feecat/PicoIndustrial/KiCadLibraries/HF46F_024-HS1T.stp

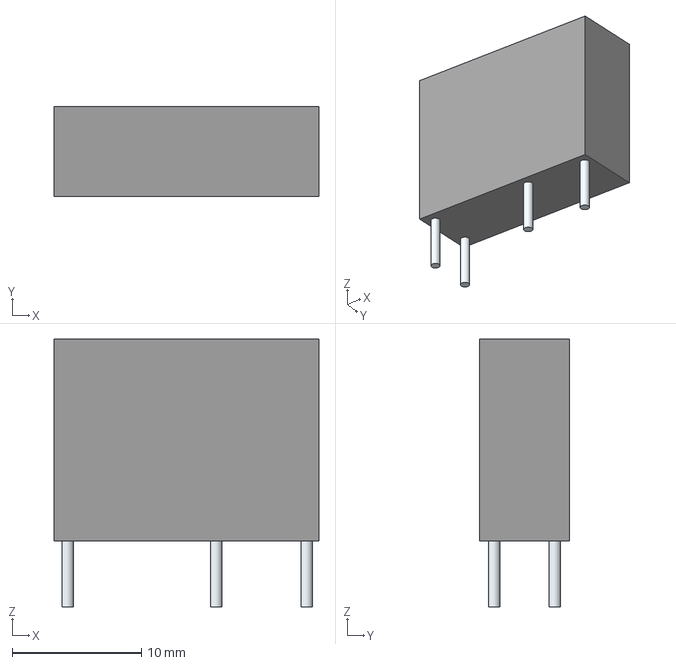
[picture p5: CAD file, 2021-03-18]
KiCadLibraries/HF46F_024-HS1T.stp
20.5 x 7.00 x 20.7 mm
Leads x 4
