feecat/PicoIndustrial/KiCadLibraries/WJ15EDGVC-3.81-12P.stp

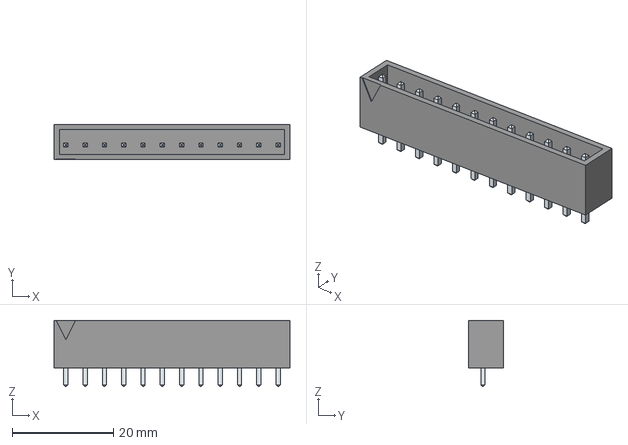
[picture p6: CAD file, 2021-03-18]
KiCadLibraries/WJ15EDGVC-3.81-12P.stp
46.6 x 7.00 x 13.1 mm
LeadsArray
