feecat/PicoIndustrial/KiCadLibraries/WJ15EDGVC-3.81-10P.stp

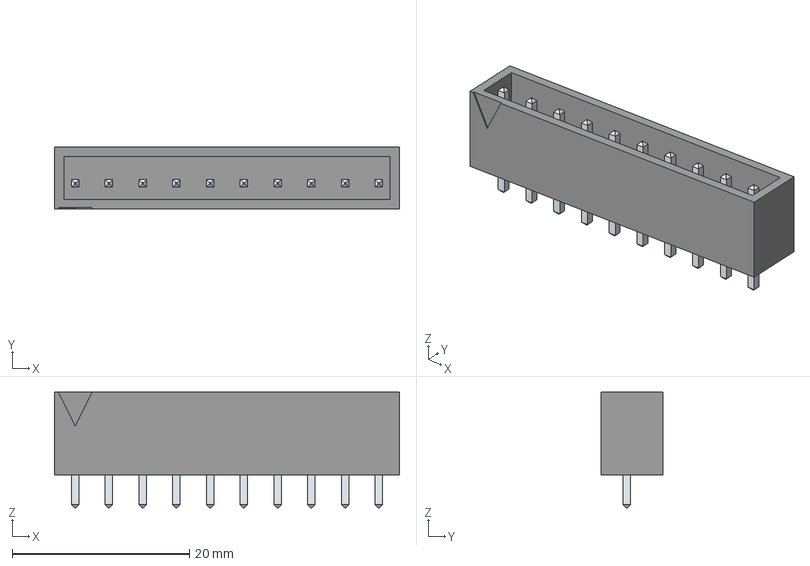
[picture p7: CAD file, 2021-03-18]
KiCadLibraries/WJ15EDGVC-3.81-10P.stp
39.0 x 7.00 x 13.1 mm
LeadsArray
