feecat/PicoIndustrial/KiCadLibraries/LM258D.stp

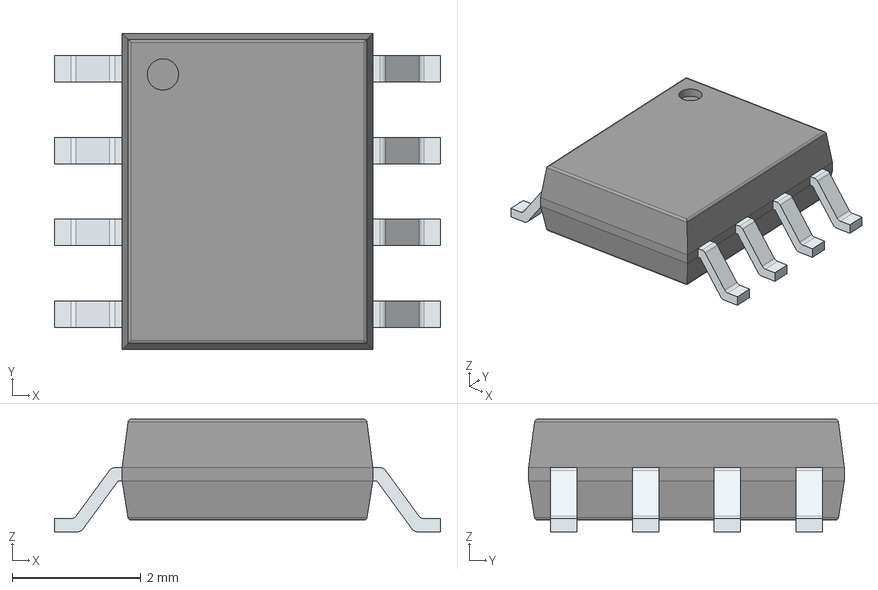
[picture p8: CAD file, 2021-03-18]
KiCadLibraries/LM258D.stp
6.00 x 4.91 x 1.75 mm
PinsArrayLR
