feecat/PicoIndustrial/PicoIndustrial.kicad_pcb

## KiCad design PicoIndustrial.kicad_pcb (2021-03-18)

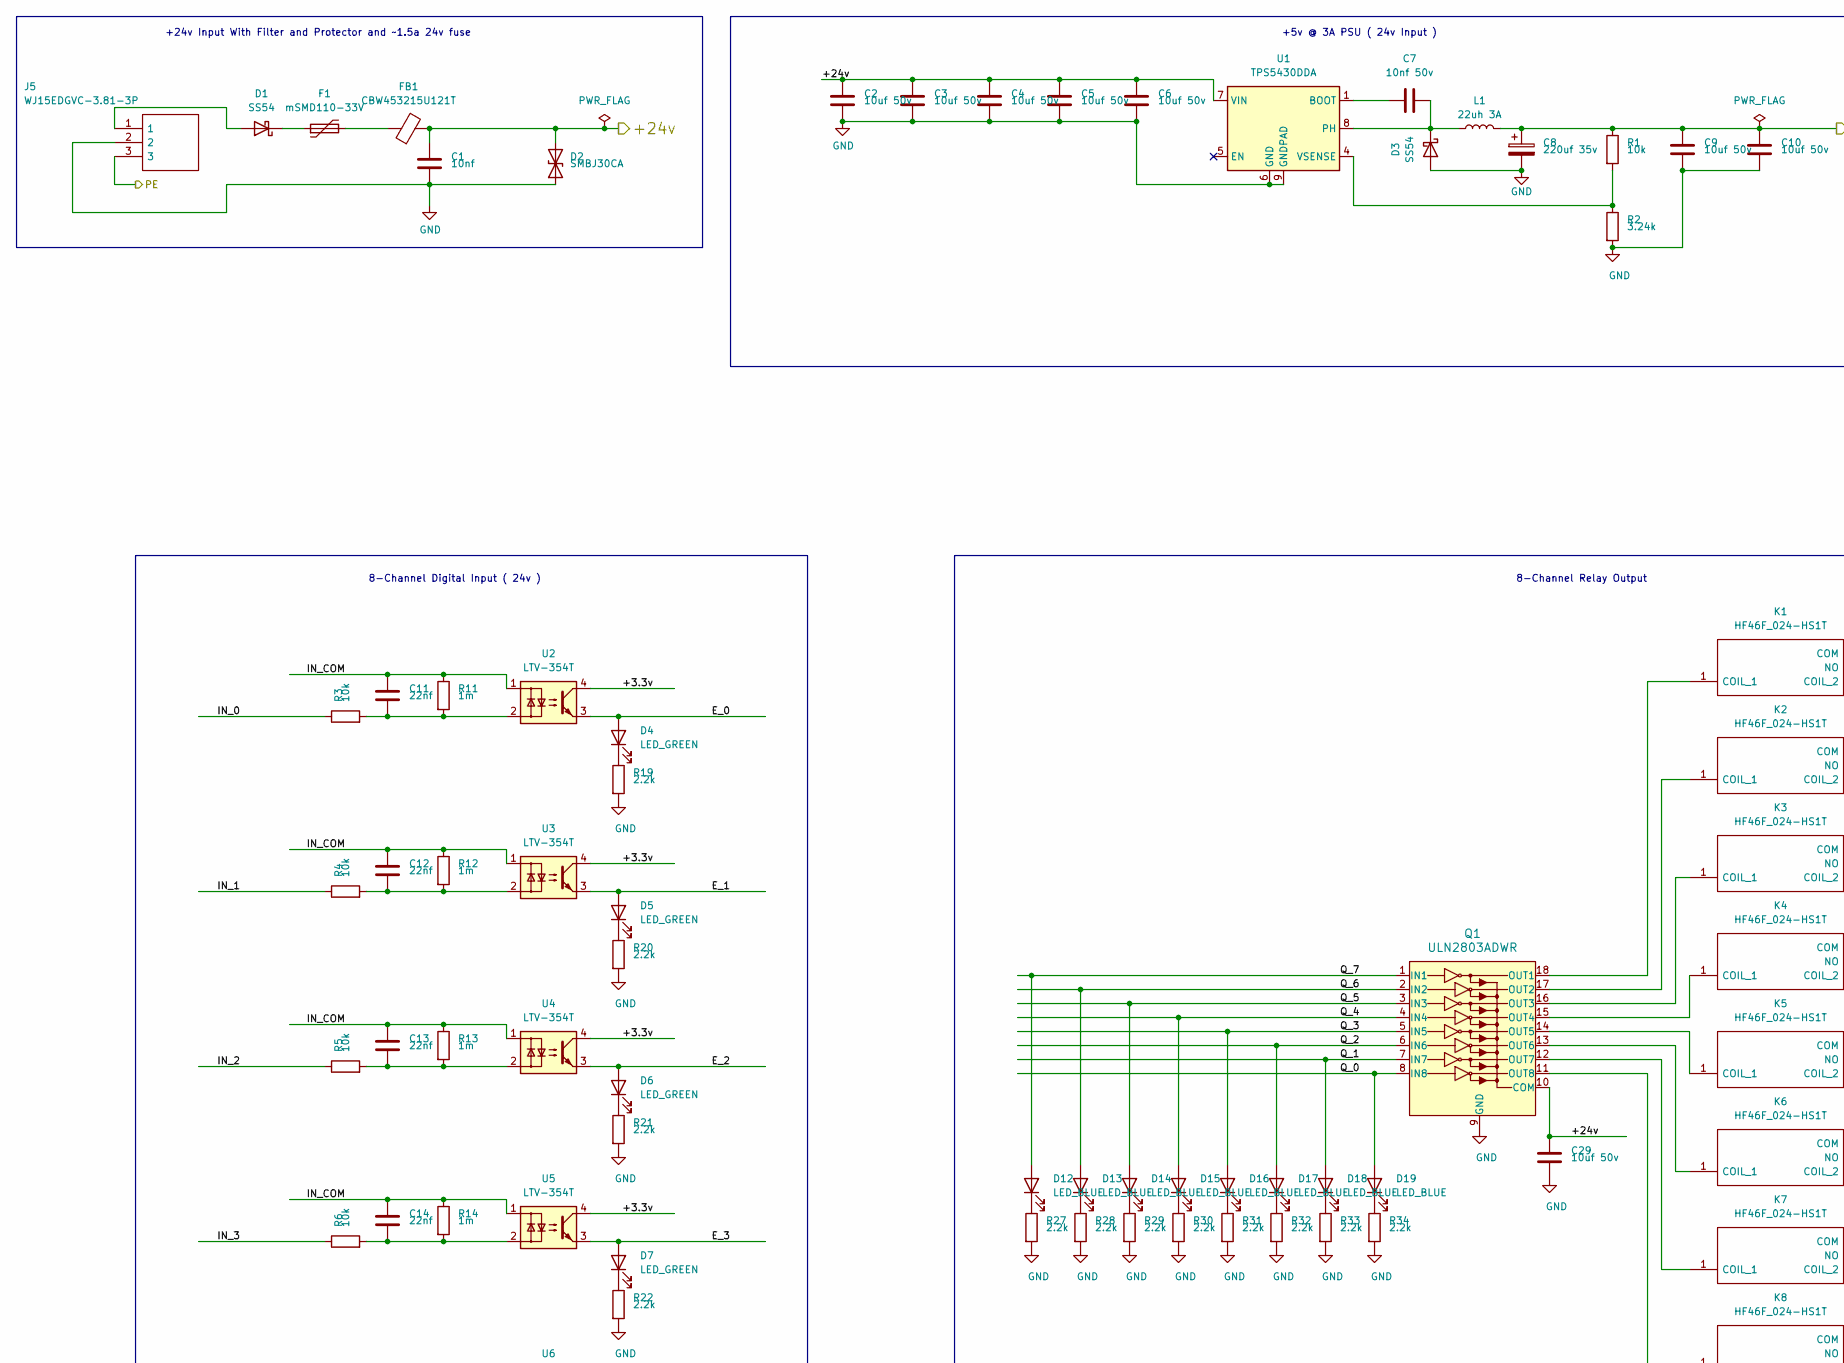
[picture p9: schematic PicoIndustrial.kicad_sch, part in row 1, column 1]

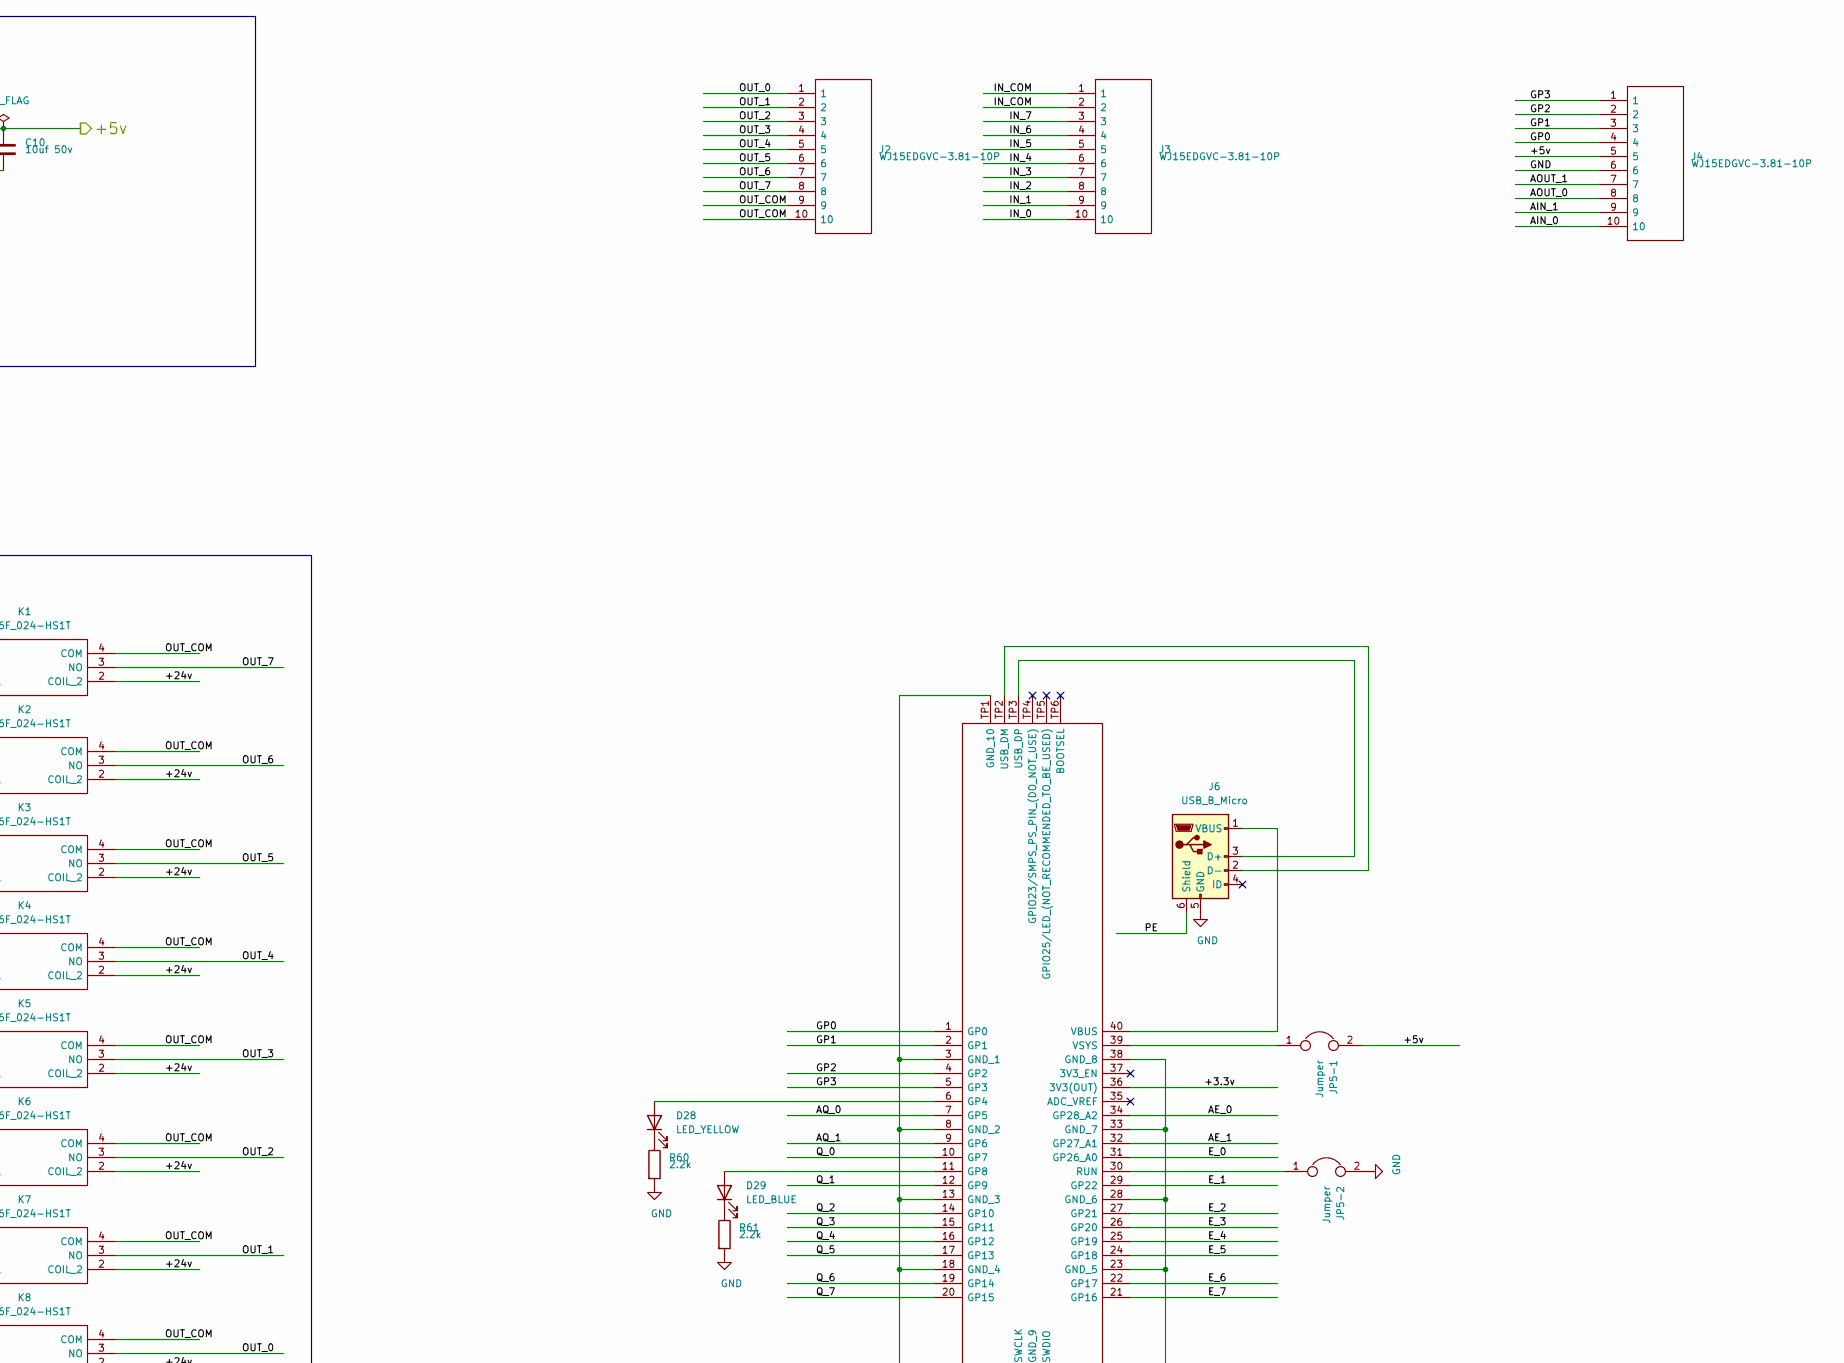
[picture p10: schematic PicoIndustrial.kicad_sch, part in row 1, column 2]

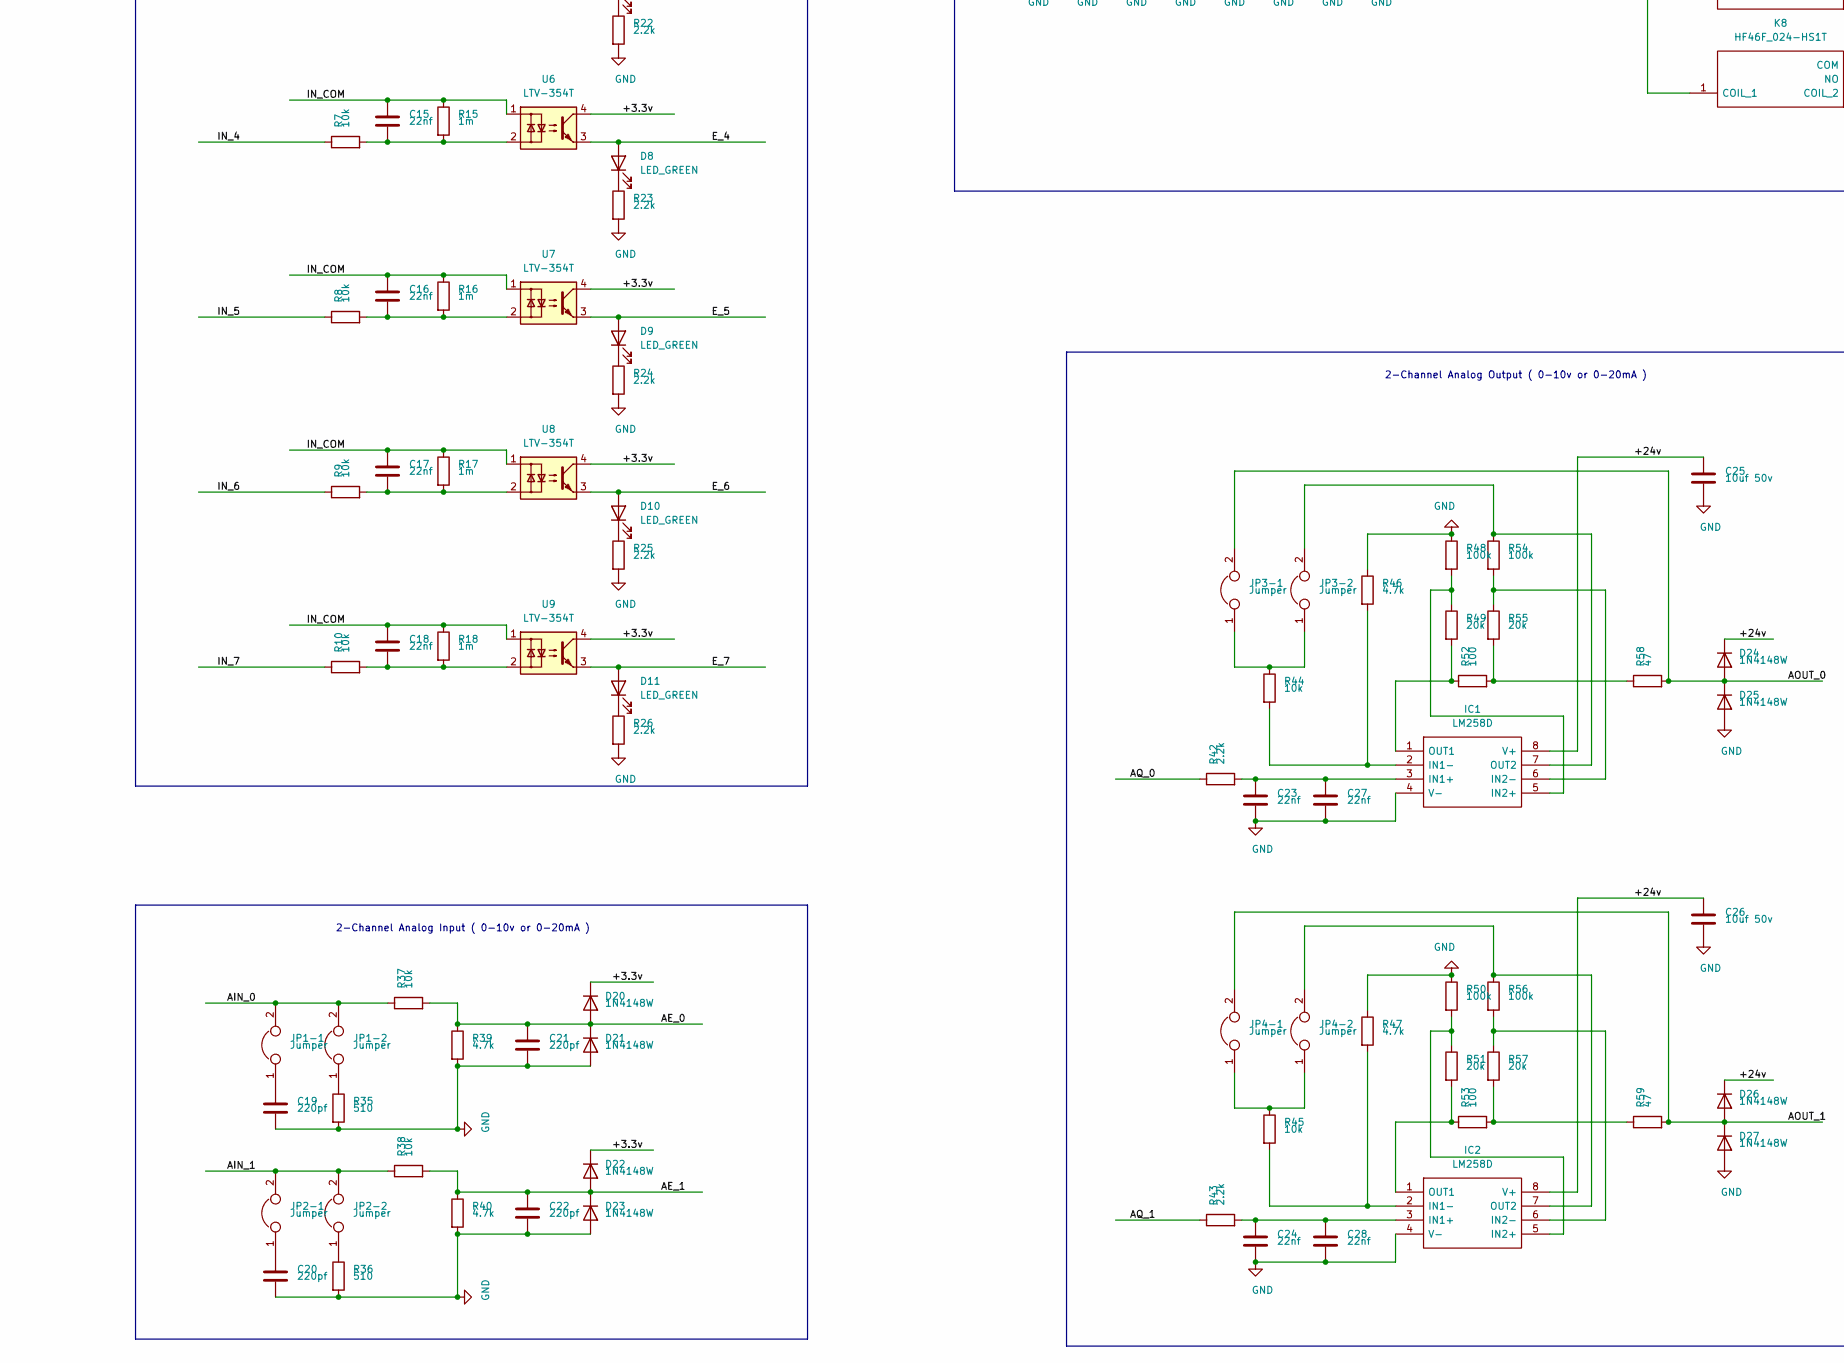
[picture p11: schematic PicoIndustrial.kicad_sch, part in row 2, column 1]

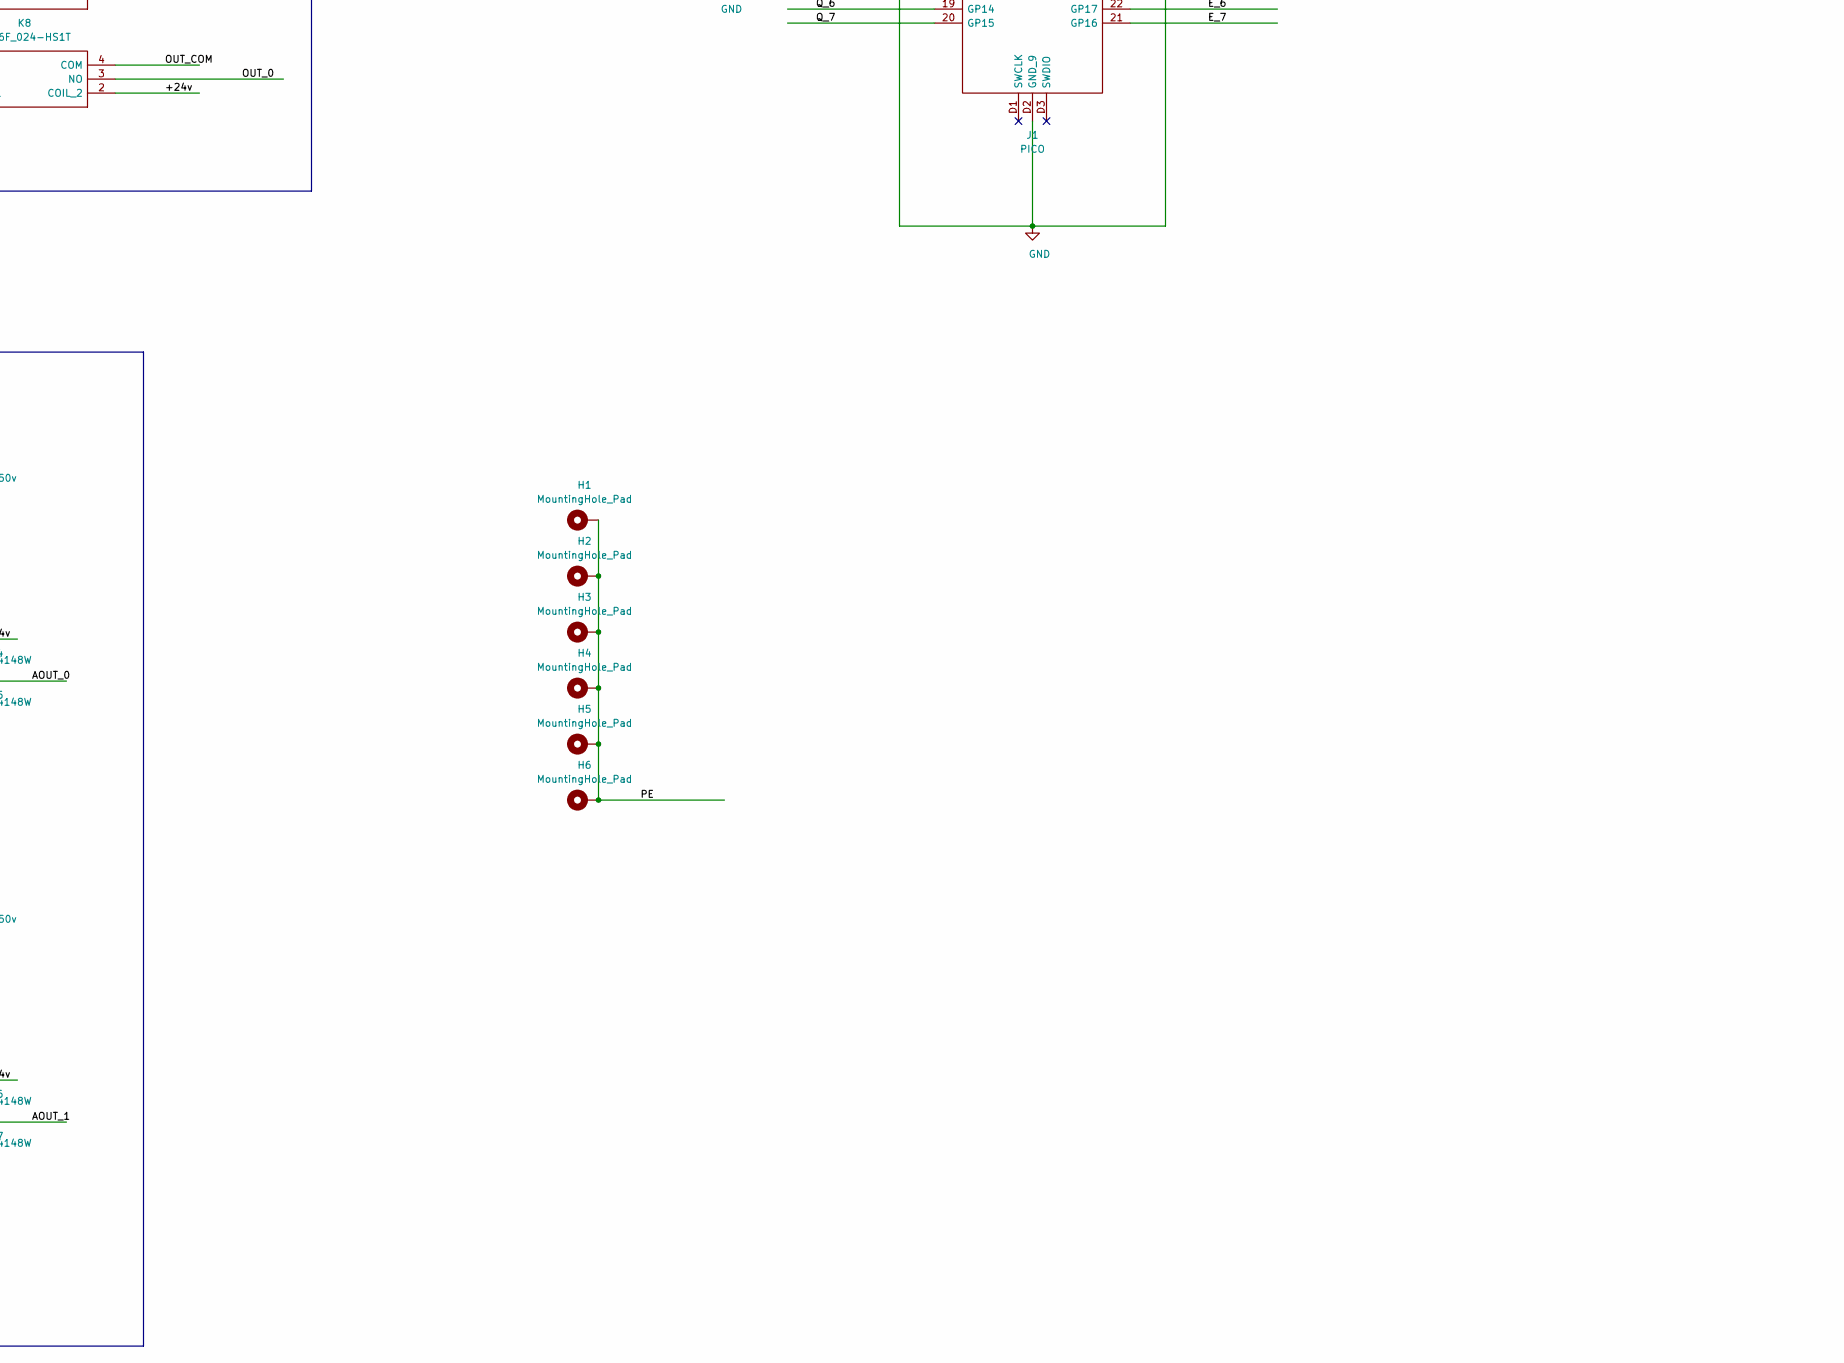
[picture p12: schematic PicoIndustrial.kicad_sch, part in row 2, column 2]

Parts:
C1: 10nf; C_1812_4532Metric; MPN 1812B103K202NT
C2, C3, C4, C5, C6, C9, C10, C25, C26, C29: 10uf 50v; C_1206_3216Metric; MPN CL31A106KBHNNNE
C7: 10nf 50v; C_0603_1608Metric; MPN CL10B103KB8NNNC
C8: 220uf 35v; CP_Elec_8x10; MPN VEH221M1VTR-0810
C11, C12, C13, C14, C15, C16, C17, C18, C23, C24, C27, C28: 22nf; C_0603_1608Metric; MPN CL10B223KB8NNNC
C19, C20, C21, C22: 220pf; C_0603_1608Metric; MPN CL10B221KB8NNNC
D1, D3: SS54; D_SMA; MPN SS54
D2: SMBJ30CA; D_SMB; MPN SMBJ30CA
D4, D5, D6, D7, D8, D9, D10, D11: LED_GREEN; LED_0603_1608Metric; MPN 19-217/GHC-YR1S2/3T
D12, D13, D14, D15, D16, D17, D18, D19, D29: LED_BLUE; LED_0603_1608Metric; MPN 19-217/BHC-ZL1M2RY/3T
D20, D21, D22, D23, D24, D25, D26, D27: 1N4148W; D_SOD-123; MPN 1N4148W
D28: LED_YELLOW; LED_0603_1608Metric; MPN 19-213/Y2C-CQ2R2L/3T(CY)
F1: mSMD110-33V; Fuse_1812_4532Metric; MPN mSMD110-33V
FB1: CBW453215U121T; L_1812_4532Metric; MPN CBW453215U121T
H1, H2, H3, H4, H5, H6: MountingHole_Pad; MountingHole_3.2mm_M3_Pad_Via
IC1, IC2: LM258D; SOIC127P600X175-8N; MPN LM258DR
J1: PICO; PICO_HOLE; MPN Pico
J2, J3, J4: WJ15EDGVC-3.81-10P; SHDR10W85P0X381_1X10_3898X700X935P; MPN WJ15EDGVC-3.81-10P
J5: WJ15EDGVC-3.81-3P; SHDR12W85P0X381_1X3_4660X700X935P; MPN WJ15EDGVM-3.81-3P
J6: USB_B_Micro; USB_Micro-B_Wuerth_614105150721_Vertical; MPN MICRO 180°JB
JP1-1, JP1-2, JP2-1, JP2-2, JP3-1, JP3-2, JP4-1, JP4-2, JP5-1, JP5-2: Jumper; TestPoint_2Pads_Pitch2.54mm_Drill0.8mm
K1, K2, K3, K4, K5, K6, K7, K8: HF46F_024-HS1T; HF46F024HS1T; MPN HF46F/24-HS1
L1: 22uh 3A; L_12x12mm_H6mm; MPN SLH1207S220MTT
Q1: ULN2803ADWR; SOIC-18W_7.5x11.6mm_P1.27mm
R1, R3, R4, R5, R6, R7, R8, R9, R10, R37, R38, R44, R45: 10k; R_0603_1608Metric; MPN 0603WAF1002T5E
R2: 3.24k; R_0603_1608Metric; MPN 0603WAF3241T5E
R11, R12, R13, R14, R15, R16, R17, R18: 1m; R_0603_1608Metric; MPN 0603WAF1004T5E
R19, R20, R21, R22, R23, R24, R25, R26, R27, R28, R29, R30, R31, R32, R33, R34, R42, R43, R60, R61: 2.2k; R_0603_1608Metric; MPN 0603WAF2201T5E
R35, R36: 510; R_1206_3216Metric; MPN 1206W4F5100T5E
R39, R40, R46, R47: 4.7k; R_0603_1608Metric; MPN 0603WAF4701T5E
R48, R50, R54, R56: 100k; R_0603_1608Metric; MPN 0603WAF1003T5E
R49, R51, R55, R57: 20k; R_0603_1608Metric; MPN 0603WAF2002T5E
R52, R53: 100; R_0603_1608Metric; MPN 0603WAF1000T5E
R58, R59: 47; R_0603_1608Metric; MPN 0603WAF470JT5E
U1: TPS5430DDA; TI_SO-PowerPAD-8_ThermalVias; MPN TPS5430DDAR
U2, U3, U4, U5, U6, U7, U8, U9: LTV-354T; SO-4_4.4x3.6mm_P2.54mm; MPN LTV-354T

Connections:
/+3.3v: D20.1 (K), D22.1 (K), J1.36 (3V3(OUT)), U2.4, U3.4, U4.4, U5.4, U6.4, U7.4, U8.4, U9.4
/+5v: C8.1, C9.1, C10.1, J4.5, JP5-1.2, L1.2, R1.1
/+24v: C1.1, C2.1, C3.1, C4.1, C5.1, C6.1, C25.1, C26.1, C29.1, D2.2 (A2), D24.1 (K), D26.1 (K), FB1.2, IC1.8 (V+), IC2.8 (V+), K1.2 (COIL_2), K2.2 (COIL_2), K3.2 (COIL_2), K4.2 (COIL_2), K5.2 (COIL_2), K6.2 (COIL_2), K7.2 (COIL_2), K8.2 (COIL_2), Q1.10 (COM), U1.7 (VIN)
/AE_0: C21.2, D20.2 (A), D21.1 (K), J1.34 (GP28_A2), R37.2, R39.1
/AE_1: C22.2, D22.2 (A), D23.1 (K), J1.32 (GP27_A1), R38.2, R40.1
/AIN_0: J4.10, JP1-1.2, JP1-2.2, R37.1
/AIN_1: J4.9, JP2-1.2, JP2-2.2, R38.1
/AOUT_0: D24.2 (A), D25.1 (K), J4.8, JP3-1.2, R58.2
/AOUT_1: D26.2 (A), D27.1 (K), J4.7, JP4-1.2, R59.2
/AQ_0: J1.7 (GP5), R42.1
/AQ_1: J1.9 (GP6), R43.1
/E_0: D4.2 (A), J1.31 (GP26_A0), U2.3
/E_1: D5.2 (A), J1.29 (GP22), U3.3
/E_2: D6.2 (A), J1.27 (GP21), U4.3
/E_3: D7.2 (A), J1.26 (GP20), U5.3
/E_4: D8.2 (A), J1.25 (GP19), U6.3
/E_5: D9.2 (A), J1.24 (GP18), U7.3
/E_6: D10.2 (A), J1.22 (GP17), U8.3
/E_7: D11.2 (A), J1.21 (GP16), U9.3
/GP0: J1.1 (GP0), J4.4
/GP1: J1.2 (GP1), J4.3
/GP2: J1.4 (GP2), J4.2
/GP3: J1.5 (GP3), J4.1
/IN_0: J3.10, R3.1
/IN_1: J3.9, R4.1
/IN_2: J3.8, R5.1
/IN_3: J3.7, R6.1
/IN_4: J3.6, R7.1
/IN_5: J3.5, R8.1
/IN_6: J3.4, R9.1
/IN_7: J3.3, R10.1
/IN_COM: C11.2, C12.2, C13.2, C14.2, C15.2, C16.2, C17.2, C18.2, J3.1, J3.2, R11.1, R12.1, R13.1, R14.1, R15.1, R16.1, R17.1, R18.1, U2.1, U3.1, U4.1, U5.1, U6.1, U7.1, U8.1, U9.1
/OUT_0: J2.1, K8.3 (NO)
/OUT_1: J2.2, K7.3 (NO)
/OUT_2: J2.3, K6.3 (NO)
/OUT_3: J2.4, K5.3 (NO)
/OUT_4: J2.5, K4.3 (NO)
/OUT_5: J2.6, K3.3 (NO)
/OUT_6: J2.7, K2.3 (NO)
/OUT_7: J2.8, K1.3 (NO)
/OUT_COM: J2.9, J2.10, K1.4 (COM), K2.4 (COM), K3.4 (COM), K4.4 (COM), K5.4 (COM), K6.4 (COM), K7.4 (COM), K8.4 (COM)
/PE: H1.1, H2.1, H3.1, H4.1, H5.1, H6.1, J5.3, J6.6 (Shield)
/Q_0: D19.2 (A), J1.10 (GP7), Q1.8 (IN8)
/Q_1: D18.2 (A), J1.12 (GP9), Q1.7 (IN7)
/Q_2: D17.2 (A), J1.14 (GP10), Q1.6 (IN6)
/Q_3: D16.2 (A), J1.15 (GP11), Q1.5 (IN5)
/Q_4: D15.2 (A), J1.16 (GP12), Q1.4 (IN4)
/Q_5: D14.2 (A), J1.17 (GP13), Q1.3 (IN3)
/Q_6: D13.2 (A), J1.19 (GP14), Q1.2 (IN2)
/Q_7: D12.2 (A), J1.20 (GP15), Q1.1 (IN1)
GND: C1.2, C2.2, C3.2, C4.2, C5.2, C6.2, C8.2, C9.2, C10.2, C19.1, C20.1, C21.1, C22.1, C23.1, C24.1, C25.2, C26.2, C27.1, C28.1, C29.2, D2.1 (A1), D3.2 (A), D21.2 (A), D23.2 (A), D25.2 (A), D27.2 (A), IC1.4 (V-), IC2.4 (V-), J1.3 (GND_1), J1.8 (GND_2), J1.13 (GND_3), J1.18 (GND_4), J1.23 (GND_5), J1.28 (GND_6), J1.33 (GND_7), J1.38 (GND_8), J1.D2 (GND_9), J1.TP1 (GND_10), J4.6, J5.2, J6.5 (GND), JP5-2.2, Q1.9 (GND), R2.2, R19.2, R20.2, R21.2, R22.2, R23.2, R24.2, R25.2, R26.2, R27.2, R28.2, R29.2, R30.2, R31.2, R32.2, R33.2, R34.2, R35.2, R36.2, R39.2, R40.2, R46.1, R47.1, R48.1, R50.1, R60.2, R61.2, U1.6 (GND), U1.9 (GNDPAD)
unnamed: C7.1, U1.1 (BOOT)
unnamed: C7.2, D3.1 (K), L1.1, U1.8 (PH)
unnamed: C11.1, R3.2, R11.2, U2.2
unnamed: C12.1, R4.2, R12.2, U3.2
unnamed: C13.1, R5.2, R13.2, U4.2
unnamed: C14.1, R6.2, R14.2, U5.2
unnamed: C15.1, R7.2, R15.2, U6.2
unnamed: C16.1, R8.2, R16.2, U7.2
unnamed: C17.1, R9.2, R17.2, U8.2
unnamed: C18.1, R10.2, R18.2, U9.2
unnamed: C19.2, JP1-1.1
unnamed: C20.2, JP2-1.1
unnamed: C23.2, C27.2, IC1.3 (IN1+), R42.2
unnamed: C24.2, C28.2, IC2.3 (IN1+), R43.2
unnamed: D1.1 (K), F1.1
unnamed: D1.2 (A), J5.1
unnamed: D4.1 (K), R19.1
unnamed: D5.1 (K), R20.1
unnamed: D6.1 (K), R21.1
unnamed: D7.1 (K), R22.1
unnamed: D8.1 (K), R23.1
unnamed: D9.1 (K), R24.1
unnamed: D10.1 (K), R25.1
unnamed: D11.1 (K), R26.1
unnamed: D12.1 (K), R27.1
unnamed: D13.1 (K), R28.1
unnamed: D14.1 (K), R29.1
unnamed: D15.1 (K), R30.1
unnamed: D16.1 (K), R31.1
unnamed: D17.1 (K), R32.1
unnamed: D18.1 (K), R33.1
unnamed: D19.1 (K), R34.1
unnamed: D28.1 (K), R60.1
unnamed: D28.2 (A), J1.6 (GP4)
unnamed: D29.1 (K), R61.1
unnamed: D29.2 (A), J1.11 (GP8)
unnamed: F1.2, FB1.1
unnamed: IC1.1 (OUT1), R49.2, R52.1
unnamed: IC1.2 (IN1-), R44.2, R46.2
unnamed: IC1.5 (IN2+), R48.2, R49.1
unnamed: IC1.6 (IN2-), R54.2, R55.1
unnamed: IC1.7 (OUT2), JP3-2.2, R54.1
unnamed: IC2.1 (OUT1), R51.2, R53.1
unnamed: IC2.2 (IN1-), R45.2, R47.2
unnamed: IC2.5 (IN2+), R50.2, R51.1
unnamed: IC2.6 (IN2-), R56.2, R57.1
unnamed: IC2.7 (OUT2), JP4-2.2, R56.1
unnamed: J1.30 (RUN), JP5-2.1
unnamed: J1.39 (VSYS), JP5-1.1
unnamed: J1.40 (VBUS), J6.1 (VBUS)
unnamed: J1.TP2 (USB_DM), J6.2 (D-)
unnamed: J1.TP3 (USB_DP), J6.3 (D+)
unnamed: JP1-2.1, R35.1
unnamed: JP2-2.1, R36.1
unnamed: JP3-1.1, JP3-2.1, R44.1
unnamed: JP4-1.1, JP4-2.1, R45.1
unnamed: K1.1 (COIL_1), Q1.18 (OUT1)
unnamed: K2.1 (COIL_1), Q1.17 (OUT2)
unnamed: K3.1 (COIL_1), Q1.16 (OUT3)
unnamed: K4.1 (COIL_1), Q1.15 (OUT4)
unnamed: K5.1 (COIL_1), Q1.14 (OUT5)
unnamed: K6.1 (COIL_1), Q1.13 (OUT6)
unnamed: K7.1 (COIL_1), Q1.12 (OUT7)
unnamed: K8.1 (COIL_1), Q1.11 (OUT8)
unnamed: R1.2, R2.1, U1.4 (VSENSE)
unnamed: R52.2, R55.2, R58.1
unnamed: R53.2, R57.2, R59.1

Notes on the sheet:
+24v Input With Filter and Protector and ~~1.5a 24v fuse
8-Channel Digital Input ( 24v )
2-Channel Analog Input ( 0-10v or 0-20mA )
+5v @ 3A PSU ( 24v Input )
8-Channel Relay Output
2-Channel Analog Output ( 0-10v or 0-20mA )

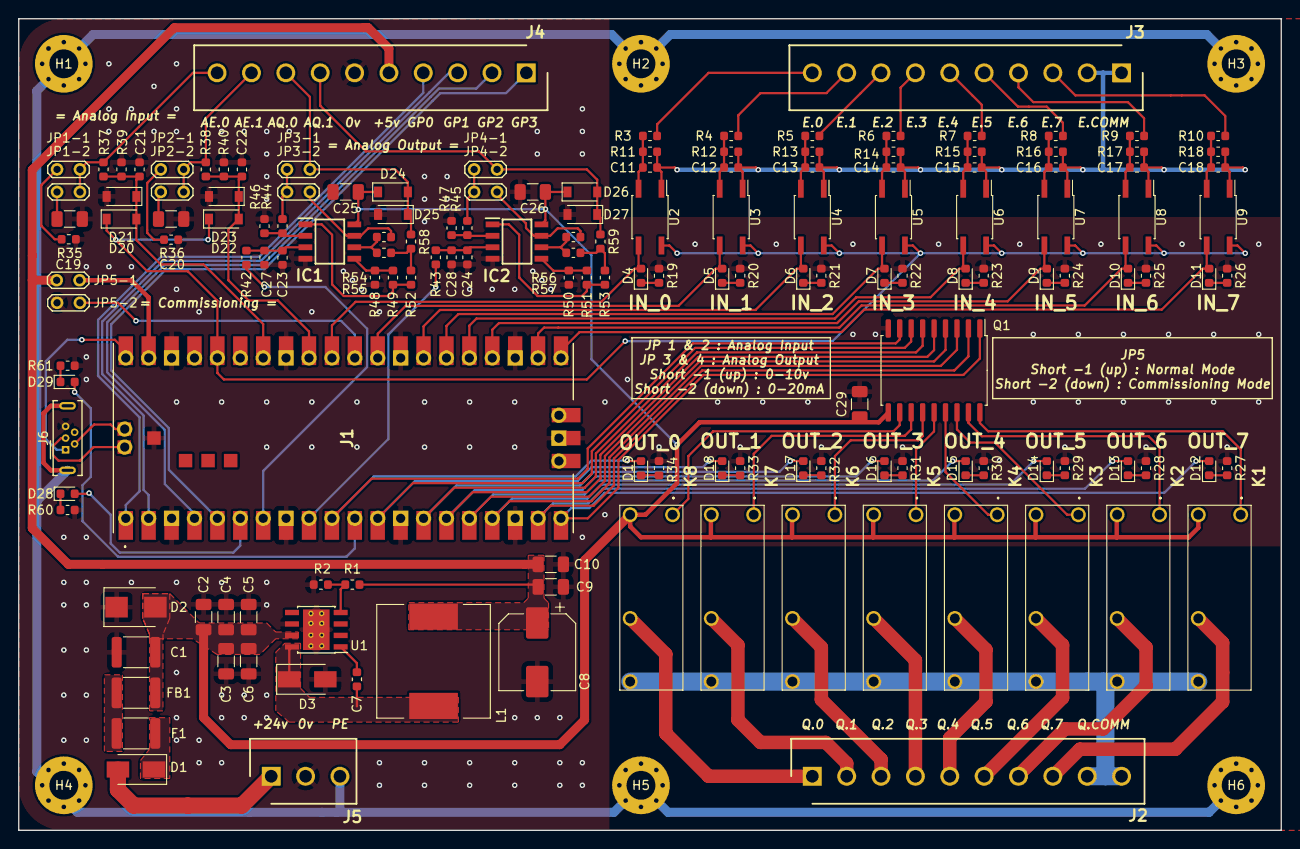
[picture p13: board PicoIndustrial.kicad_pcb from above]

Board: 2 copper layers, 140.0 x 90.0 mm, 163 parts (0 on the bottom side), 118 nets.
